zgray8298/gillis-v2/docs/design-v15.docx

Gillis V2.0 — Wiring & Pinout Reference

Rev4.1 · April 2026

# 1. System overview

Gillis is a moving-table CNC laser welder for battery-pack tab welding. The gantry is fixed; the table under it carries the cells and moves in X (left/right to the operator) and Y (toward/away from the operator). Three CL57Y closed-loop stepper drivers run the two Y motors (dual) and one X motor. A pneumatic Z head carries the presser foot and drops onto each cell before firing.

Control is split between a Teensy 4.1 (real-time motion, safety, I/O) and a Raspberry Pi 4 (user interface, program library, run orchestrator). They talk over USB CDC at 115200 baud, data-only — no power crosses the USB link.

## 1.1 Hardware list

- Teensy 4.1 (ARM Cortex-M7 @ 600 MHz, 3.3 V I/O, VBUS pad CUT — irreversible, performed during production wiring. Pendant cable carries no VBUS conductor (only D+/D- and a shared 0 V), so neither side can back-feed the other regardless of supply state. USB still enumerates because the Teensy’s USB peripheral does not require VBUS-detect to bring up the D+ pull-up: the chip is powered from VIN on the DDR-30G-5, the firmware initialises the USB stack, the Pi sees the pull-up and enumerates the device)
- Raspberry Pi 4 Model B, Official 7" DSI touchscreen
- 3 × CL57Y closed-loop stepper drivers (X, Y-left, Y-right)
- 1 × 8-channel LOW→HIGH opto isolator board — Amazon ASIN B08LVXX6MV (NPN/PNP input, NPN output)
- 1 × 8-channel HIGH→LOW opto isolator board — Amazon ASIN B08LVXK6L2 (NPN/PNP input, NPN output)
- 1 × 4-channel relay board (5 V, 3.3 V-compatible trigger, built-in per-channel opto)
- 5 × RS PRO PNP inductive/optical sensors (X home, Y-left home, Y-right home, Z up, Z down) — 24 V, sourcing output
- 1 × 0–150 psi stainless-steel pressure transducer (ratiometric 0.5–4.5 V on 5 V supply)
- 24 V main PSU feeding both the electronics box and the pendant; each has its own local 5 V buck

# 2. Power architecture

The 24 V main rail is generated centrally and splits into two mechanical enclosures: the electronics box (next to the gantry) and the operator pendant. Each enclosure has its own local 24 V → 5 V conversion — they do not share a 5 V rail.

### Electronics box

- 24 V → 5 V DC-DC (≥ 3 A) powers the relay board, the 5 V logic side of both opto boards, the air-pressure sensor and the Teensy (via VIN).
- ★ The Teensy VBUS solder pad is CUT in this build (irreversible). Cut was performed during production wiring. The Teensy is now powered exclusively from the DDR-30G-5 5 V rail via VIN and USB is a pure data link. The pendant cable carries no VBUS conductor (only D+/D- and a shared 0 V), so there is no path for the Pi to back-feed Teensy VIN — the failure mode anticipated in Rev4.14 (PSU off + USB plugged in → Pi USB overcurrent latch) is structurally impossible with this cable allocation. USB enumeration still succeeds despite VBUS-detect being unconnected on the chip side: the Teensy’s USB peripheral brings up the D+ pull-up as soon as VIN is on and the firmware initialises the USB stack, and the Pi enumerates on seeing the pull-up. Rev4.14’s premise that a VBUS conductor was required in the cable for enumeration to work was incorrect — it isn’t needed.
- Stepper motor rails are wired directly to the drivers (CL57Y handles its own motor-side supply) and do not touch Teensy logic.

### Pendant

- Local 24 V → 5 V buck (≥ 3 A) powers the Pi 4 and the 7" touchscreen ONLY.
- The Pi’s USB is connected to the Teensy for control messaging via the pendant cable. The cable carries only D+, D-, and a shared 0 V (which doubles as the 24 V return) — there is no VBUS conductor. With the Teensy’s VBUS pad cut and no VBUS on the cable, the chip’s VBUS-detect line is permanently unconnected; however the USB peripheral does not require VBUS-detect to enumerate. The Teensy enables its D+ pull-up as soon as VIN power is applied and the firmware initialises the USB stack, and the Pi enumerates on seeing the pull-up. With no VBUS path between Pi and Teensy in either direction, no back-feed of VIN can occur regardless of supply state. See the pendant cable allocation table for the full breakdown.

### Firmware flashing procedure (with VBUS pad cut)

With the VBUS pad cut, the Teensy can no longer be powered by USB alone — external 5 V on VIN is mandatory. To reflash from a development PC, swap the USB connection at the Teensy from the pendant cable to the laptop, but leave VIN connected throughout so the Teensy keeps running. The pendant USB and the laptop USB MUST NOT be plugged into the Teensy at the same time — that puts two USB hosts on one device and risks confused enumeration.

- Confirm the DIN-rail 5 V PSU is on. Teensy must have VIN power throughout the procedure — flashing will fail if VIN drops because the chip itself loses power.
- Disconnect the pendant USB cable from the Teensy USB connector. Pi can stay running — it will see the device disappear, no harm done. The 24 V, E-stop, and pendant power circuits remain connected throughout; only the USB lead is moved.
- Plug a regular USB cable from the development PC into the Teensy USB connector. Because VIN is already powering the Teensy, plugging USB does NOT cause a reboot — the chip is already up and just sees a new host appear on the data lines. Teensyduino can now issue a software reboot-to-bootloader and flash the new firmware exactly as it does in any USB-powered scenario.
- After upload completes, unplug the PC USB cable from the Teensy. Reconnect the pendant USB cable. The Pi’s serial-port watcher will re-enumerate the Teensy and the GUI will reconnect automatically.

Mounting tip: to avoid opening the electronics enclosure for every reflash, position the Teensy so its USB connector sits flush with a slot in the enclosure side, OR fit a USB-A bulkhead pass-through wired to a short USB pigtail that normally plugs into the Teensy. To reflash, unplug pendant from the bulkhead and plug the laptop in instead. Same swap, done at the box edge instead of inside.

Alternative — flash from the Pi: install teensy_loader_cli (or the Arduino IDE / arduino-cli) on the Pi and flash directly over the existing pendant USB link. Eliminates the cable swap entirely but requires the toolchain to be available on the Pi. Recommended once the firmware stabilises; cable-swap is fine for active development.

### Grounding

- All 24 V GNDs tie together at the PSU; all 5 V GNDs tie to the 24 V GND at the electronics-box DC-DC output (star point).
- Signal GND between Teensy and Pi is established by the USB shield/GND lead. Do not break it.

### Earthing (PE)

Plastic enclosure — no metal frame to bond. Two PE wires from the C14 inlet’s PE pin run in parallel, one to each mains-fed PSU’s safety earth input:

- C14 PE pin → SDR-480-48 PE input
- C14 PE pin → XDR-240E-24 FG (Frame Ground) input

No PE busbar required — the C14’s PE crimp accepts both wires in parallel. PE conductor gauge matches the L/N supply (typically 1.5 mm²), green/yellow striped per IEC 60204-1.

Not bonded to PE: CL57Y driver chassis (downstream of earthed SDR-480, no mains potential exposure on fault); DC 0 V star point (kept floating relative to PE for noise immunity); cable shields (terminate to DC 0 V at the enclosure end, not PE).

# 3. System wiring diagram

The diagram below shows the complete power and signal topology: the 24 V main supply, both 24 V → 5 V conversions, the Teensy 4.1 pin usage, both opto isolator boards with their channel assignments, the three CL57Y drivers (with ALM return paths), the 4-channel relay board, the air-pressure sensor divider, and the pendant branch.

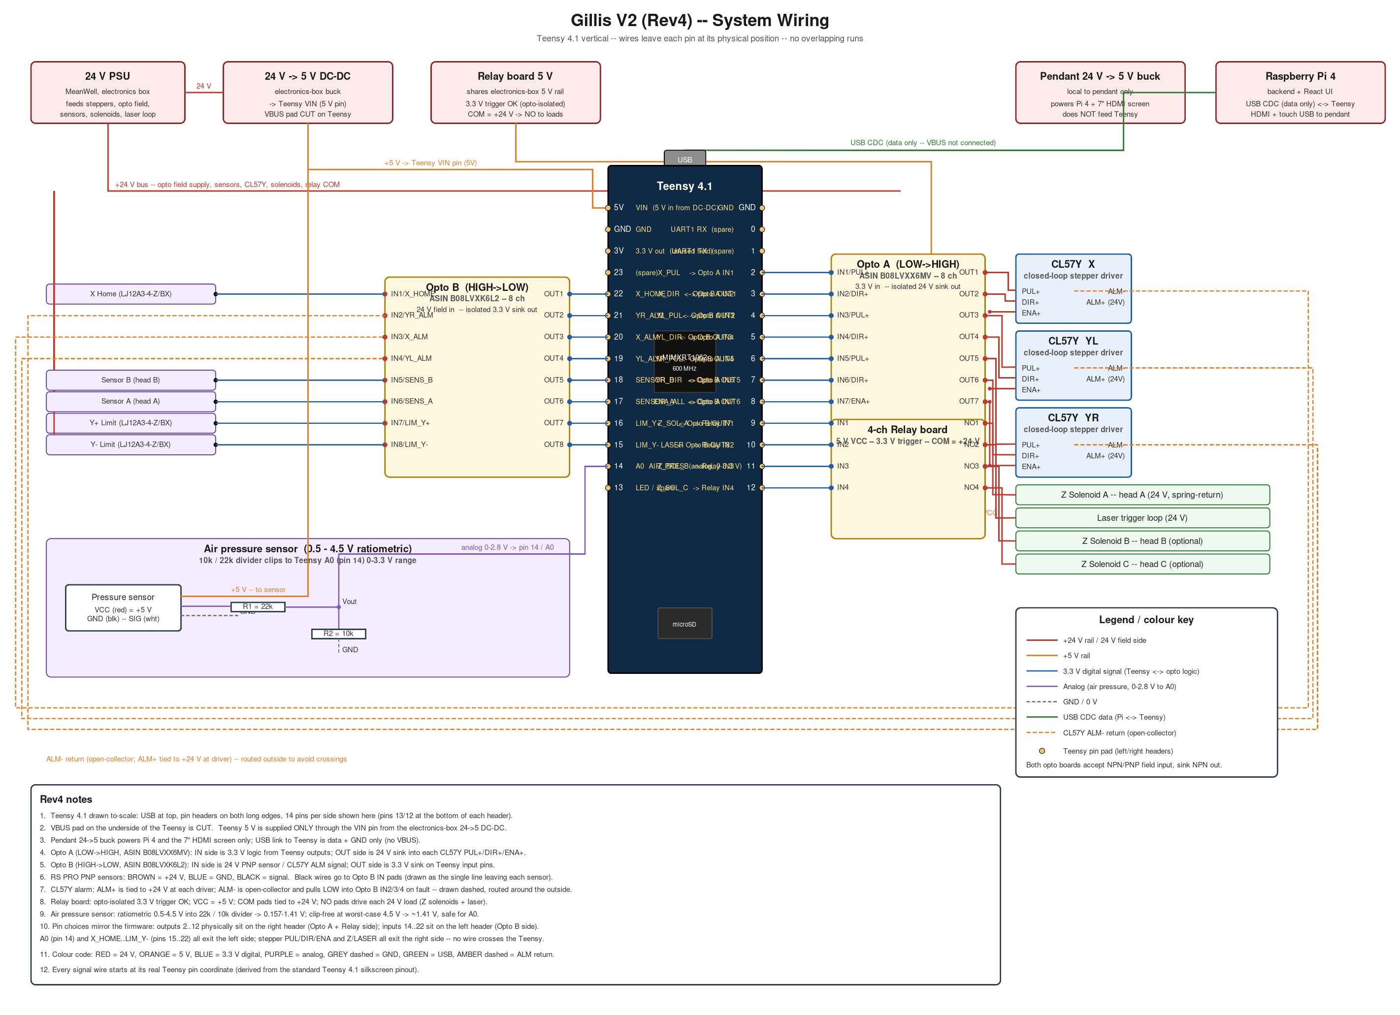
[picture p1: figure]
System wiring: 24 V PSU, electronics-box 24 V→5 V DC-DC, Teensy 4.1, LOW→HIGH and HIGH→LOW opto boards, 3× CL57Y drivers, relay board, sensors, air-pressure sensor, and pendant branch.

Figure 1 — Gillis V2 (Rev4) system wiring

### 3.1 Opto-board conventions

- Opto Board A (LOW → HIGH, B08LVXX6MV) translates Teensy 3.3 V outputs to isolated 5 V drives for the CL57Y step/dir/enable inputs. The board has a SINGLE VCC pin on the OUTPUT-side terminal block (top row); set this to 5 V from the electronics-box DDR-30G-5 (not the 24 V XDR rail). Output-side GND ties to system 0 V at the star point. Input-side (bottom row) accepts 3.3 V Teensy GPIO on the IN pins; input COM ties to Teensy GND. Input-voltage range is fixed by the on-board RP resistor pack — this unit has RP marking A471J (470 Ω, designed for ~5 V drive, gives ~4.5 mA LED current at 3.3 V). No DIP switches or solder jumpers — the RP is non-configurable in the field. Why 5 V (not 24 V) for VCC: the board’s 10 kΩ output-side pull-up array (visible as the SOIC-package “103” marking) would dissipate up to ~460 mW total at 24 V with all 8 channels active, pushing the pack near its thermal rating. At 5 V the same pull-ups dissipate <25 mW total — huge margin. The CL57Y inputs accept 5–24 V natively (manual Ch 4.3.1) so 5 V is comfortably in range.
- Opto Board B (HIGH → LOW, B08LVXK6L2) takes 24 V sensor outputs and CL57Y ALM open-collector signals and presents them to the Teensy as active-LOW inputs. The board has a SINGLE VCC pin on the OUTPUT-side terminal block (top row); set this to 3.3 V from the Teensy. Output-side GND ties to Teensy GND. Input-side (bottom row) accepts 24 V on the IN pins; input COM ties to 24 V GND for PNP-sourcing sensors and CL57Y ALM– returns. Input-voltage range is fixed by the on-board RP resistor pack — this unit has RP marking A472J (4.7 kΩ, designed for 24 V drive, gives ~4.85 mA LED current). No DIP switches or solder jumpers. Why 3.3 V (not 5 V) for VCC: the board has onboard pull-ups on each OUT pin that hold the line at VCC when the channel is idle. With VCC = 5 V, idle OUT pins would put 5 V onto Teensy 3.3 V GPIOs — out of spec, risk of GPIO damage over time. VCC = 3.3 V keeps idle pins at 3.3 V, safe for Teensy.

Both boards are "NPN/PNP input → NPN output" — they can accept either polarity on the field side (we use PNP-sourcing for sensors and the driver ALMs in pull-down-on-fault mode) and their outputs pull to GND when the input is active. That matches the firmware's INPUT_PULLUP configuration: no external pull-ups are needed.

### 3.2 CL57Y ALM wiring

The CL57Y ALM output is an optocoupler transistor between ALM+ and ALM–. With no fault it is open; on fault the transistor conducts. Wire ALM+ to +24 V and ALM– to the field-side input of Opto Board B (IN6 / IN7 / IN8). When the driver faults, the transistor pulls the opto input LOW, the opto output on the 3.3 V side turns ON (pulls to GND), and the Teensy sees the pin go LOW — consistent with every other active-LOW sensor in the firmware.

### 3.3 Air-pressure sensor

The 0–150 psi transducer runs on 5 V and outputs ratiometrically from 0.5 V (0 psi) to 4.5 V (150 psi). That peaks above the Teensy's 3.3 V analogue range, so a simple 10 kΩ / 22 kΩ divider scales it: ratio 22/(10+22) = 0.6875, giving 0.34 V at 0 psi and 3.09 V at 150 psi — comfortably inside the ADC range. Firmware uses analogReadResolution(12).

Wiring: RED → +5 V (electronics-box DC-DC), BLACK → GND, GREEN → top of divider → Teensy A0 (pin 14) tap.

# 4. Teensy 4.1 pin assignments

All digital outputs are 3.3 V and should be routed to the field side of the appropriate isolation board — Teensy GPIO does not drive 24 V loads directly. The one exception is the 4-channel relay board, which accepts a 3.3 V trigger and has its own per-channel opto built in.

### 4.1 Stepper control (outputs via Opto Board A)

Pin | Name | Direction / Level | Notes
2 | PIN_X_STEP | OUT, 3.3 V pulse | Step for X axis; min 1 µs pulse width, active HIGH. Via Opto A → CL57Y X PUL- (common-positive wiring; PUL+ ganged to +5 V).
3 | PIN_X_DIR | OUT, 3.3 V level | Direction for X; HIGH = +X. Via Opto A → CL57Y X DIR- (DIR+ ganged to +5 V).
4 | PIN_YL_STEP | OUT, 3.3 V pulse | Step for Y-left. Via Opto A → CL57Y YL PUL- (PUL+ ganged to +5 V).
5 | PIN_YL_DIR | OUT, 3.3 V level | Direction for Y-left. Via Opto A → CL57Y YL DIR- (DIR+ ganged to +5 V).
6 | PIN_YR_STEP | OUT, 3.3 V pulse | Step for Y-right. Via Opto A → CL57Y YR PUL- (PUL+ ganged to +5 V).
7 | PIN_YR_DIR | OUT, 3.3 V level | Direction for Y-right. Via Opto A → CL57Y YR DIR- (DIR+ ganged to +5 V).
8 | PIN_ALL_ENABLE | OUT, 3.3 V level | Single opto channel to all three ENA- pins (ganged). ENA+ on each driver ties to +5 V. LOW = enabled. Boots HIGH (disabled) until the Pi issues ENABLE.

### 4.2 Relay board outputs (direct 3.3 V trigger)

Pin | Name | Direction / Level | Notes
9 | PIN_Z_SOLENOID_A | OUT, 3.3 V level | Relay ch1 — Head A Z solenoid (energise = DOWN, spring-return UP). Active LOW at Teensy (relay board energises on IN LOW).
10 | PIN_LASER_RELAY | OUT, 3.3 V level | Relay ch2 — Laser trigger loop. Active LOW at Teensy for FIRE dwell only (relay board energises on IN LOW).
11 | PIN_Z_SOLENOID_B | OUT, 3.3 V level | Relay ch3 — Head B Z solenoid (Rev4; firmware ready, wiring optional until Head B fitted). Active LOW at Teensy.
12 | PIN_Z_SOLENOID_C | OUT, 3.3 V level | Relay ch4 — Head C Z solenoid (Rev4; firmware ready, wiring optional). Active LOW at Teensy.

### 4.3 Sensor inputs (via Opto Board B; active LOW at Teensy)

Pin | Name | Direction / Level | Notes
22 | PIN_X_HOME | IN, INPUT_PULLUP | X home/limit. Moved 14→22 in Rev4 bench testing to free A0; update harness.
15 | PIN_Y_LEFT_HOME | IN, INPUT_PULLUP | Y-left home/limit.
16 | PIN_Y_RIGHT_HOME | IN, INPUT_PULLUP | Y-right home/limit.
17 | PIN_Z_UP_SENSOR | IN, INPUT_PULLUP | Z head fully retracted (UP).
18 | PIN_Z_DOWN_SENSOR | IN, INPUT_PULLUP | Z head seated DOWN on cell.

### 4.4 CL57Y fault inputs (via Opto Board B; active LOW at Teensy)

Pin | Name | Direction / Level | Notes
19 | PIN_X_DRIVER_ALM | IN, INPUT_PULLUP | X driver ALM. Wire: ALM+ → +24 V, ALM– → Opto B IN6.
20 | PIN_Y_LEFT_ALM | IN, INPUT_PULLUP | Y-left driver ALM. ALM– → Opto B IN7.
21 | PIN_Y_RIGHT_ALM | IN, INPUT_PULLUP | Y-right driver ALM. ALM– → Opto B IN8.

### 4.5 Analogue input

Pin | Name | Direction / Level | Notes
14 (A0) | PIN_AIR_PRESSURE | ANALOGUE, 12-bit | Air-pressure sensor via 10 k / 22 k divider. Scaling lives in config.h.

# 5. Opto board channel maps

## 5.1 Opto Board A — LOW → HIGH (B08LVXX6MV)

Teensy 3.3 V outputs drive the input-side opto LEDs; each output-side NPN transistor pulls the corresponding CL57Y signal to 0 V (output-side GND) when the Teensy pin is HIGH. Use the board’s COM (output-side) as the CL57Y signal return. Output-side VCC = 5 V from the DDR-30G-5 (see §3.1 for why 5 V not 24 V, and for the RP-fixed input voltage).

Ch | Logic-side source | Field-side destination | Notes
IN1 | Teensy Pin 2 (X_STEP) | CL57Y X PUL- | 5 V opto drive to driver step input
IN2 | Teensy Pin 3 (X_DIR) | CL57Y X DIR- | Driver direction input
IN3 | Teensy Pin 4 (YL_STEP) | CL57Y YL PUL-
IN4 | Teensy Pin 5 (YL_DIR) | CL57Y YL DIR-
IN5 | Teensy Pin 6 (YR_STEP) | CL57Y YR PUL-
IN6 | Teensy Pin 7 (YR_DIR) | CL57Y YR DIR-
IN7 | Teensy Pin 8 (ALL_ENA) | All 3 CL57Y ENA- | Single channel ganged to all drivers
IN8 | — spare — | — | Unused; leave disconnected

## 5.2 Opto Board B — HIGH → LOW (B08LVXK6L2)

Each 24 V field input drives the optocoupler LED; the logic-side NPN transistor pulls the Teensy input to GND when active. Teensy pins are set INPUT_PULLUP, so no external pull-up resistors are required.

Ch | Logic-side source | Field-side destination | Notes
IN1 | X_HOME sensor (BLK) | Teensy Pin 22 | RS PRO PNP 24 V sensor → active LOW at Teensy
IN2 | YL_HOME sensor (BLK) | Teensy Pin 15
IN3 | YR_HOME sensor (BLK) | Teensy Pin 16
IN4 | Z_UP sensor (BLK) | Teensy Pin 17
IN5 | Z_DOWN sensor (BLK) | Teensy Pin 18
IN6 | X driver ALM– | Teensy Pin 19 | ALM+ → +24 V; open-collector pulls ALM– to GND on fault
IN7 | YL driver ALM– | Teensy Pin 20
IN8 | YR driver ALM– | Teensy Pin 21

★ Using 3 of the 8 fault inputs for CL57Y ALM takes the HIGH→LOW board to full capacity (5 sensors + 3 ALM = 8). If you add Head B / Head C Z sensors in future, a second HIGH→LOW opto board will be required.

# 6. Connector reference

### 6.1 RS PRO PNP sensor wiring

- BROWN → +24 V
- BLUE → 24 V GND
- WHITE → Opto Board B input (PNP NC output — sources +24 V when sensor IS triggered with the sensor variant in use, after BLACK was found to give inverted polarity at the Teensy on 2026-05-03; see Rev4.7 entry)

### 6.2 CL57Y driver wiring

- PUL+ / DIR+ / ENA+ — ganged together to +5 V from electronics-box DDR-30G-5 (common-positive wiring per CL57Y manual page 9). All three + pins per driver share a single +5 V tap; can also be ganged across all 3 drivers to a single +5 V wire if convenient.
- PUL- / DIR- / ENA- ← Opto Board A channel OUT pin (each - pin to its respective channel: PUL- → step channel OUT, DIR- → dir channel OUT, ENA- → Ch7 OUT, ganged across all 3 drivers since ENA is shared). When the channel activates (Teensy IN HIGH), the opto NPN closes and pulls the - pin to GND, completing the LED loop from +5 V → CL57Y internal LED + 1.5 kΩ current limiter → - pin → opto NPN → GND. Result: ~2.5 mA LED activation, well above the EL814’s reliable threshold.
- ALM+ → +24 V (tied at driver)
- ALM– → Opto Board B input (channel per driver)

Motor + encoder wiring (StepperOnline 23HS40-5004D-E1K-1M5):

The motor ships with two cables. The thicker 4-conductor (TRVV4×0.5mm²) is the motor power cable; the thinner 6-conductor shielded (TRVVP6×0.2mm²) is the encoder cable. Wire colours overlap between the two cables — identify by conductor count (4 vs 6) before stripping.

Motor power cable (4-conductor, 0.5 mm²):

Motor wire | Phase | CL57Y terminal
BLK (Black) | A+ | A+
GRN (Green) | A- | A-
RED (Red) | B+ | B+
BLU (Blue) | B- | B-

Encoder cable (6-conductor shielded, 0.2 mm²) — 1000 PPR / 4000 CPR after quadrature decode:

Encoder wire | Function | CL57Y terminal
BLK (Black) | Encoder A+ | EA+
BLU (Blue) | Encoder A- | EA-
YEL (Yellow) | Encoder B+ | EB+
GRN (Green) | Encoder B- | EB-
RED (Red) | +5 V to encoder | VCC
WHT (White) | Encoder GND | EGND

Cable shield drain: terminate to CL57Y chassis at one end only (driver end). Don’t land on EGND — that injects shield-drain current into the encoder ground reference. Common failure modes if mis-wired: A↔A- swap causes immediate 5-flash position-overrun alarm on first commanded move; VCC↔EGND swap kills the encoder silently; A pair swapped with B pair causes erratic motion at low speeds (90° phase shift in feedback).

### 6.3 Relay board wiring (4-channel, 5 V)

- VCC → electronics-box 5 V, GND → common
- If the board has a JD-VCC / VCC jumper, leave it fitted (Teensy-powered trigger side)
- IN1 ← Pin 9 (Z_SOL_A), IN2 ← Pin 10 (LASER), IN3 ← Pin 11 (Z_SOL_B), IN4 ← Pin 12 (Z_SOL_C)
- Each relay: COM = +24 V, NO = solenoid / laser trigger loop, GND = 24 V GND
- Each pneumatic solenoid coil MUST have flyback diode protection — either built into the DIN 43650 connector OR added externally as a 1N4007. Without it, back-EMF spikes (100–500 V transients during de-energise) radiate enough EMI to trigger spurious driver fault signals at the Teensy even with ALM signal wires physically disconnected. See §6.3.1 below for installation instructions.

### 6.3.1 Flyback diode installation (per solenoid)

Step 1 — Test if the existing connector has a diode. Unplug the DIN 43650 connector from the valve. Set multimeter to diode-test mode. Probe across L+ and N– in BOTH directions: forward direction shows ~1.7–2.0 V (LED forward voltage); reverse direction shows ~0.7 V if a flyback diode is present, OL (open) if only an LED is fitted. If reverse reads OL on any solenoid, that solenoid needs an external diode added.

Step 2 — Add 1N4007 across each unprotected coil. 1N4007 (or any 1N400x with x ≥ 4): 1 A, 1000 V. CRITICAL ORIENTATION: cathode end (silver/grey band) goes to the COIL + side (the wire that comes from the relay NO terminal); anode (plain end) goes to the COIL – side (the GND return). Wired backwards, the diode shorts the coil and prevents it from energising at all.

Installation location options (best to worst):

- Inside the DIN 43650 connector body (open the connector, install across the L+ and N– screw terminals, close back up) — closest to the source, best EMI suppression.
- Replace the LED-only connector with an LED-and-diode variant (Heschen and similar sell “with surge suppressor” versions ~£3–5 each).
- At the relay-board terminal block end (slide the diode leads into the same screw terminals as the existing wires from relay NO and GND). Electrically equivalent to the connector-end install but slightly worse for EMI radiation along the wire run.

After installing diodes on all 3 solenoids, verify by triggering each one from the GUI: relay clicks, valve actuates, no driver-fault dialogs appear in the GUI. If false faults persist with all 3 diodes installed, suspect a 24 V supply rail dip (add a 100 μF bulk capacitor at the relay board’s +24 V input) or shared-ground noise (re-route solenoid wiring away from Teensy/Opto B signal cables, twist + and – conductors together).

### 6.4 Air-pressure sensor wiring

- RED = +5 V (electronics-box DC-DC)
- BLACK = GND
- GREEN = signal through 10 kΩ (top) / 22 kΩ (bottom) divider to Teensy A0 (pin 14)

### 6.5 CL57Y dip switch settings

Set on each of the three drivers. Power-cycle the driver (drop and re-apply 24 V on V+) after any dip-switch change — settings are read at boot only.

SW | Function | Setting | Reason
SW1 | Pulse mode | OFF | PU&DR mode (single pulse + direction signal). Matches firmware which drives PIN_X_STEP and PIN_X_DIR as separate signals.
SW2 | Direction | OFF* | *Verify per axis at commissioning. OFF = CW when DIR active. For dual-Y (YL+YR), the two motors face each other so they typically need OPPOSITE SW2 settings to drive the gantry the same linear direction.
SW3 | Servo mode | OFF | Servo mode 1 — smoother low-speed response, suited to heavy gantry with slow precise moves. Servo mode 2 (ON) is for light loads with fast positioning.
SW4 | ALM polarity | OFF | ALM signal normally OPEN (transistor closes on fault). Matches existing ALM wiring in §3.2 (ALM+ to +24 V, ALM- pulled to GND on fault).
SW5 | Microstep bit 0 | OFF | Combined with SW6/SW7/SW8 to set 3200 pulses/rev (16 microsteps × 200 full steps). Matches firmware MICROSTEPS=16 in config.h.
SW6 | Microstep bit 1 | OFF | Same as above — 3200 pulses/rev.
SW7 | Microstep bit 2 | ON | Same as above — 3200 pulses/rev.
SW8 | Microstep bit 3 | ON | Same as above — 3200 pulses/rev. Result: 640 steps/mm with 5 mm-pitch ballscrews; 128 kHz pulse rate at 200 mm/s (36% headroom under CL57Y’s 200 kHz max).

If you ever change MICROSTEPS in firmware: SW5–SW8 must match. CL57Y manual Ch 4.2.2 has the full pulses/rev table. For example, doubling to 32 microsteps (6400 pulses/rev) would need SW5/SW6/SW7=ON, SW8=OFF and a config.h update — but check the max pulse rate (640 × 2 = 1280 steps/mm; at 200 mm/s = 256 kHz, exceeds CL57Y’s 200 kHz limit). 16× is the practical maximum for this mechanical setup.

# 7. Firmware-visible behaviour

- All sensor inputs and ALM inputs are active LOW at the Teensy pin. This is consistent across every input on both opto boards, which keeps the firmware's INPUT_PULLUP + digitalRead checks uniform.
- ALL_ENABLE is active LOW at the CL57Y driver. Firmware boots with Teensy Pin 8 HIGH, which keeps the opto off → CL57Y ENA+ / ENA– open → drivers DISABLED. The Pi issues ENABLE once the UI is ready.
- FIRE pulses the laser relay LOW for dwell_ms configured in settings.h (the 4-ch 24 V relay board is active-LOW at its 3.3 V trigger inputs); the relay board's built-in opto handles isolation.
- Z solenoid energise lowers the Z head; spring-return lifts it when relay drops.
- The Pi-side heartbeat PINGs every 500 ms; firmware trips FAULT_LINK_LOST after 2000 ms silence (watchdog, see master plan §8).

# 8. E-stop architecture and always-on rail

The E-stop kills two power paths simultaneously through a pair of DPDT relays driven from a single NC button loop. Hardware power is restored automatically on E-stop release; the firmware provides the latch via a GUI-acknowledged FAULT state (see §8.4).

## 8.1 Hardware topology

- Relay R1 (Mxuteuk PTF08A-E, DPDT, 24 VDC coil) — both poles used to switch AC L AND AC N to the 48 V SDR-480-48 PSU. Double-pole isolation per IEC 60204-1; single-pole break is not used. NO contacts on both poles, so coil-energised = AC delivered.
- Relay R2 (Mxuteuk PTF08A-E, DPDT, 24 VDC coil) — one pole used to switch +24 V (high-side) to the 4-channel relay board which drives the Heschen 4V210-08 pneumatic solenoid coils. Pole 2 left as a spare. NO contact, so coil-energised = +24 V delivered to solenoids.
- E-stop button — normally-closed (NC) contacts, positive opening per IEC 60947-5-5. Wired in series with both relay coils, so press → loop opens → both coils drop together. Broken wire produces same shutdown (fail-safe direction).
- No hardware latch — releasing the E-stop re-energises both coils and restores AC + 24 V immediately. The firmware fault-state (§8.4) acts as the operator-acknowledged latch.
- Coil supply — both R1 and R2 coils take +24 V from the always-on rail (XDR-240E output, upstream of R2’s contacts). The coils’ 0 V return goes directly to the XDR 0 V. Coil current ~30 mA each, well within the E-stop contact rating.

## 8.2 Mxuteuk PTF08A-E pin reference

PTF08A-E sockets carry 8 numbered terminals (1–8) for an 8-pin DPDT relay (MY2N-J style). Pin functions and physical positions below are verified against the printed diagram on the actual relay body and the annotated socket photo (Figure 2).

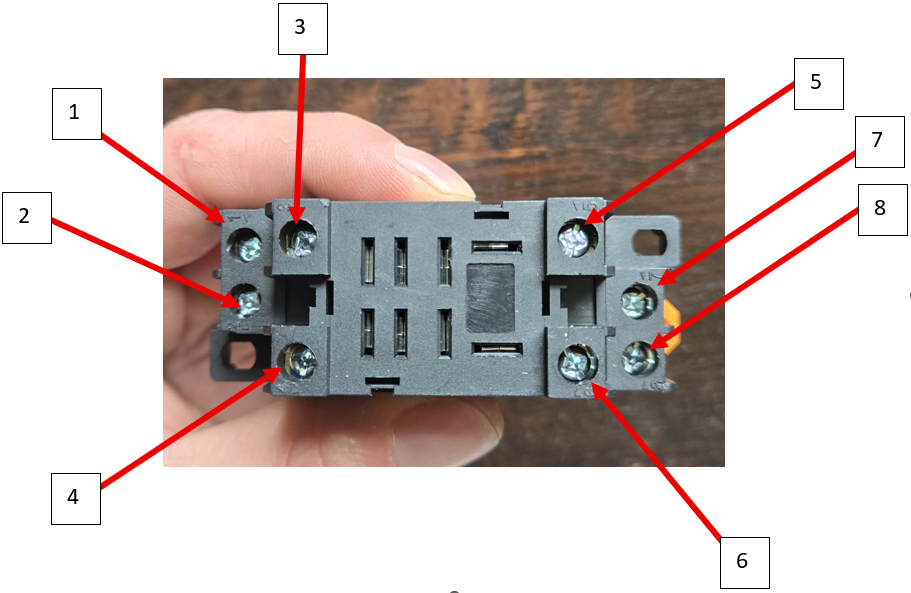
[picture p2: figure]
Annotated Mxuteuk socket photo

Figure 2 — Mxuteuk PTF08A-E DIN-rail socket, annotated with physical pin positions.

Pin | Position | Function | R1 connection (AC switching) | R2 connection (24 V switching)
1 | Top-outer-left | NC pole 1 | unused (spare) | unused (spare)
2 | Mid-outer-left | NC pole 2 | unused (spare) | unused (spare)
3 | Top-inner-left | COM pole 1 | AC L from C14 inlet (after main switch) | +24 V from XDR always-on rail
4 | Bottom-outer-left | COM pole 2 | AC N from C14 inlet | unused (pole 2 spare)
5 | Top-inner-right | NO pole 1 | AC L → SDR-480-48 input L | switched +24 V → 4-ch relay board +24 V
6 | Bottom-inner-right | NO pole 2 | AC N → SDR-480-48 input N | unused (pole 2 spare)
7 | Top-outer-right | Coil A2 (−) | 0 V system GND | 0 V system GND
8 | Mid-outer-right | Coil A1 (+) | +24 V via E-stop NC contact | +24 V via E-stop NC contact (parallel with R1 pin 8)

Contact rating: 10 A @ 250 VAC / 5 A @ 30 VDC, well above the SDR-480-48’s ~3 A AC draw and the solenoid bank’s ~0.75 A peak DC. Coil: 24 VDC variant required.

## 8.3 Always-on rail — NOT cut by E-stop

The XDR-240E-24 is wired directly to the C14 mains inlet (upstream of R1) so its 24 V output is available regardless of E-stop state. The following loads draw from this always-on rail and remain powered when E-stop is pressed:

- Electronics-box 24→5 V DC-DC — feeds Teensy VIN, opto-board logic side, the 4-ch relay board logic, and the air-pressure transducer. Keeps the firmware running so it can detect driver alarms (§3.2) and transition to FAULT.
- Pendant 24→5 V buck (Pi 4 + 7” touchscreen) — GUI stays responsive during E-stop so the operator can see and dismiss the FAULT.
- R1 + R2 coil supply — control loop runs from the always-on rail through the E-stop NC contacts. The coil supply itself is never gated; only the loop’s closure state changes.

Loads that ARE cut by E-stop: AC mains to the SDR-480-48 (so +48 V to the three CL57Y drivers disappears), and +24 V to the 4-channel relay board (so all pneumatic valves spring back to safe state).

## 8.4 Fault-state behaviour (firmware latch via GUI)

Hardware auto-restores power on E-stop release, but the machine cannot operate until the operator dismisses the fault on the Pi GUI. The chain is:

- E-stop pressed → R1 drops → +48 V cut to all three CL57Y drivers.
- Drivers detect loss-of-power and assert their ALM open-collector outputs (ALM– pulled to GND).
- Opto Board B IN6/IN7/IN8 see the 24 V drop → logic-side outputs pull Teensy pins 19/20/21 LOW.
- Firmware reads the active-LOW alarm pins and transitions the state machine to FAULT.
- Pi GUI displays the fault and blocks all motion commands.
- E-stop released → R1 + R2 re-energise → 48 V and 24 V return — but firmware stays in FAULT.
- Operator clicks “Acknowledge fault” on the GUI → firmware toggles ALL_ENABLE (Pin 8 HIGH→LOW transition) to clear the driver-side alarm latch → state machine returns to IDLE.

CL57Y alarm reset (verified against StepperOnline CL57Y manual V1.0, Chapter 5):

Fault (red ALM flash count) | Flashes | Reset method
Overcurrent / interphase short | 1× | Power-off reset only (full V+ cycle).
Overvoltage of supply | 2× | Auto-recovers when V+ returns to spec range.
Undervoltage of supply | 3× | Auto-recovers when V+ returns to spec range.
Drive overtolerance (position over-error) | 5× | MF/ENA toggle (drive Pin 8 HIGH briefly) clears alarm. Power-off also works.

For Gillis V2 the E-stop case is the easy one: pressing E-stop fully cuts V+ at the SDR-480-48 output, so each CL57Y is hard power-cycled. On release, the drivers reboot fresh with no latched alarm state — no firmware ENA toggle is required to clear an E-stop-induced fault. The firmware just needs to wait for the ALM pins to indicate no fault before re-issuing ENABLE (Pin 8 LOW) and returning to IDLE.

The firmware ENA toggle IS still needed for the 5-flash “position over-tolerance” fault that occurs during normal operation when V+ never dropped — this latches and the manual states it’s cleared by setting MF (the enable input) to its “invalid” / disabled state. That maps to driving Teensy Pin 8 HIGH (which the firmware already does at boot), then back LOW to re-enable.

Related dip-switch settings (verify on each driver): SW4 = OFF (“ALM signal normally open”) — this matches the existing wiring (ALM+ to +24 V, ALM– pulled LOW on fault). SW1, SW2, SW3 set per axis; SW5–SW8 set the microstep subdivision per the manual’s table (16 settings from 400 to 51200 pulses/rev).

# 9. DC fusing

Five DC fuses on the bench, plus the C14 inlet’s integral mains fuses (not in this list — they protect the AC side and are sized to the upstream breaker).

# | Rating | Size / format | Location | Reason

1 | T5 A slow-blow | 5×20 mm ceramic | X driver V+ (between 48 V busbar and CL57Y X V+ pin) | Per-driver isolation; rides through V+ cap inrush at boot.
2 | T5 A slow-blow | 5×20 mm ceramic | YL driver V+ (between 48 V busbar and CL57Y YL V+ pin) | Per-driver isolation.
3 | T5 A slow-blow | 5×20 mm ceramic | YR driver V+ (between 48 V busbar and CL57Y YR V+ pin) | Per-driver isolation.
4 | T1 A slow-blow | 5×20 mm glass | DDR-30G-5 5 V output → Teensy and downstream 5 V loads (opto board logic, 4-ch relay logic side, air sensor, CL57Y +pin gangs) | Catches downstream shorts faster than DDR-30G-5’s ~6 A onboard current limit. Typical 5 V load is ~300–500 mA, 1 A leaves margin without nuisance-tripping on Teensy boot.
5 | T2 A slow-blow | 5×20 mm glass | 24 V XDR output → pendant cable (Pi 4 + 7” touchscreen via pendant buck) | Continuous ~250–400 mA; ~1 A inrush during Pi boot. T2 A handles inrush without nuisance-tripping.

## 9.1 Branches deliberately NOT fused

- 4-ch relay board 24 V input — gated by R2; the 4-ch board itself fans out to 3 solenoid coils. Continuous load ~420 mA worst case; XDR’s onboard current limit handles a sustained short.
- E-stop control loop (24 V → E-stop NC → R1+R2 coils → 0 V) — coil current ~60 mA total. A blown fuse here would silently disable the E-stop, which is an unacceptable failure mode. Rely on XDR’s current limit.
- Sensor BROWN wires individually — 5 sensors share the +24 V bus; per-sensor fuses would add 5 wear items for marginal benefit. Upstream protection (XDR current limit) handles a single sensor short.
- 3.3 V from Teensy to opto board logic VCCs — Teensy onboard 3.3 V regulator current limits at ~250 mA. The regulator IS the fuse for this rail.
- DDR-30G-5 24 V input — protected by the XDR’s current limit + the DDR’s own input under-voltage / reverse-polarity protections. (If you ever want belt-and-braces, T3.15 A 5×20 mm slow-blow rides through the DDR’s 15 A inrush.)

# 10. Change log

- Rev4.15 (2026-05-13): Spec corrections from BOM review with Zack. (a) Removed §8.3 bullet for “HG30 MPG handwheel” — confirmed never built and never to be built; the pendant has no MPG. The Pi + screen power-retention behaviour during E-stop is already covered by the existing “Pendant 24→5 V buck” bullet. Also removed the stray HG30 mention from the Rev4.2 entry below. (b) Removed “SONGLE” branding from §4.2 pin notes (ch1, ch2) and §7 FIRE description — the installed 4-channel relay board is the 24 V coil variant with built-in optos, driven direct from Teensy 3.3 V GPIO. The SRD-05VDC-SL-C / SONGLE attribution in the Rev4.12 entry below is incorrect; the active-LOW behaviour documented there is correct and unchanged. (c) Partially revised Rev4.14 below: the Teensy VBUS pad IS cut as that entry states, BUT the pendant cable does NOT carry +5 V VBUS — Zack confirmed only D+/D- and a shared 0 V run through the cable. The chip’s VBUS-detect line is therefore permanently unconnected, yet USB enumeration works fine because the Teensy’s USB peripheral does not require VBUS-detect to bring up the D+ pull-up — once VIN powers the chip and the firmware initialises USB, the Pi sees the pull-up and enumerates. With no VBUS path in either direction, no back-feed of VIN can occur regardless of supply state, so the original concern that motivated Rev4.14 is structurally resolved by the cable allocation alone. Updated §1.1, §2 power architecture, and §6 pendant cable description to reflect this. Firmware-flashing subsection title and intro left as Rev4.14 wrote them — they are correct since the pad really is cut.
- Rev4.14 (2026-05-09): Reversed §1.1 / §2 VBUS guidance: pad is now CUT and the pendant cable now carries +5 V VBUS on a dedicated conductor. Trigger was the production-wiring brownout failure mode (PSU off + USB plugged in = Pi USB overcurrent latch + Teensy offline). Cutting the pad and routing VBUS through the cable makes this failure class structurally impossible: USB powers only the chip’s VBUS-detect pin, never VIN. Pendant 6-core allocation reorganised — the previous separate 24 V-to-pendant-buck wire and 24 V-to-E-stop-input wire are merged into a single 24 V supply (split at the pendant end into buck input and E-stop button input), freeing one core for VBUS. New allocation: (1) 24 V, (2) +5 V VBUS, (3) E-stop return, (4) D+, (5) D-, (6) shared 0 V/GND. Added firmware-flashing-with-pad-cut subsection documenting the cable-swap workflow now required for reflashing.
- Rev4.13 (2026-05-05): Expanded §6.3 with new §6.3.1 covering flyback diode installation. The integrated DIN 43650 connectors on Gillis V2’s Heschen 4V210-08 valves were verified to have LED indicators only (no flyback diode). Without flyback protection, solenoid back-EMF spikes radiate sufficient EMI to trigger spurious FAULT_DRIVER_X / YL / YR events at the Teensy (random pin susceptibility), even with the ALM signal wires physically disconnected from Opto Board B — the EMI couples directly into the Teensy chip. Mandatory: install a 1N4007 across each solenoid coil with cathode (band) toward the relay-NO side. Subsection details the multimeter test for diode presence, install location ranking, and post-install verification.
- Rev4.12 (2026-05-05): SAFETY-CRITICAL FIX: 4-ch SONGLE relay board (SRD-05VDC-SL-C) verified empirically as ACTIVE-LOW input, not active-HIGH as previously documented. Pulling IN to GND fires the opto and energises the relay; idle HIGH state leaves it de-energised. Firmware updated across pins.h boot init, fault_handler.h emergency_stop_outputs, z_control.h z_deenergise_all + z_down, and serial_protocol.h laser_fire to invert HIGH/LOW writes accordingly. Without this fix, the firmware’s boot init was writing all four relay outputs LOW with the comment “all OFF on boot” — in reality this energised all 3 Z solenoids and asserted the laser fire signal at every Teensy reset, before firmware took over. Hazard mitigated by R2’s gating of +24 V to the relay board until E-stop close, but still a latent boot-time fault. §4.2, §7, §2 updated to reflect active-LOW convention.
- Rev4.11 (2026-05-05): Mxuteuk PTF08A-E pin reference (§8.2) verified empirically against the printed contact diagram on the actual relay body and against an annotated socket photo (now embedded as Figure 2). Pin functions corrected from prior assumed mapping: 1=NC1, 2=NC2, 3=COM1, 4=COM2, 5=NO1, 6=NO2, 7=A2 (–), 8=A1 (+). R1 connections updated: AC L lands on pin 3, AC N on pin 4; switched outputs on pins 5 (L) and 6 (N); coil + on pin 8, coil – on pin 7. R2 same pattern, only pole 1 used. Added §2 Earthing subsection: in this plastic enclosure with no PE busbar, two parallel PE wires run from the C14 inlet’s PE pin direct to the SDR-480 PE input and the XDR-240E FG input. CL57Y chassis bonds, 0V↔PE bond, and cable-shield-to-PE all deliberately omitted with reasoning.
- Rev4.10 (2026-05-03): Section 9 driver fuses changed from 10×38 mm DIN ceramic (PV-style) to 5×20 mm ceramic, slow-blow, 250 V (T5 A). Holders identified as IEC 60947-7-1 compliant 5×20 fuse holders for the 24 V branch — same physical format works for the 48 V driver branches given the SDR-480-48’s onboard ~10 A output current limit (well within 5×20 ceramic breaking capacity at 48 V DC). All 5 fuses now standardised on 5×20 mm slow-blow ceramic, sourced from a single AUKENIEN 75-piece kit covering T0.5A through T20A.
- Rev4.9 (2026-05-03): Added Section 9 covering DC fusing — 5 fuses total (3× T5 A 10×38 DIN on per-driver V+, 1× T1 A 5×20 glass on DDR-30G-5 5 V output to Teensy, 1× T2 A 5×20 glass on 24 V to pendant cable). Plus §9.1 listing branches deliberately not fused (4-ch relay board input, E-stop loop, individual sensors, 3.3 V Teensy regulator output, DDR-30G-5 24 V input) with reasoning. Renumbered Change log from 9 to 10.
- Rev4.8 (2026-05-03): Reversed the “Teensy VBUS pad MUST be cut” advice in §1.1 and §2 (Power architecture). The pendant cable carries only D+/D- and a shared 0 V — no VBUS conductor — so no Pi-to-VIN power fight is possible in production regardless of pad state. Critically, leaving the pad INTACT supplies VBUS-detect locally from VIN, which the Teensy’s USB controller needs to enumerate; cutting the pad with no external VBUS source would prevent USB enumeration entirely. Pad cut is also irreversible. The previous “cut” advice was based on an assumed full-USB cable topology that doesn’t match Gillis V2’s actual pendant wiring.
- Rev4.7 (2026-05-03): Section 4.1 and Section 5.1 updated to show Teensy step/dir/enable signals routing to the CL57Y – pins (not + pins) per the corrected common-positive wiring in §6.2. Section 6.1 sensor wire colour changed from BLACK to WHITE – with the specific RS PRO sensor variant in use, BLACK gave inverted polarity at the Teensy (sensor idle read as triggered), causing homing to immediately think the gantry was at home and skip the seek motion. WHITE (PNP NC output) gives the correct polarity. Added FAULT_Y_GANTRY_RACK firmware fault: during homing, if the first Y home sensor triggers but the second doesn’t follow within 500 ms (configurable as HOMING_Y_DUAL_TIMEOUT_MS), motion stops immediately and the firmware faults — protects the gantry from racking if one Y motor stalls or one home sensor fails.
- Rev4.6 (2026-05-03): Section 6.2 CL57Y signal wiring corrected to common-positive (+ pins ganged to +5 V, - pins to opto OUT) — the previous “+ to OUT, - to GND” topology gave only ~0.3 mA LED current via the 10 kΩ pull-up, well below the CL57Y opto threshold, causing motor to not respond to PUL/DIR/MF signals. New wiring sources current properly through the opto NPN sink path, ~2.5 mA LED current. Section 6.2 now also documents motor power and encoder cable colour mapping for the StepperOnline 23HS40-5004D-E1K-1M5. New Section 6.5 added covering CL57Y dip switches SW1–SW8 with chosen settings and reasoning, including the 16-microstep / 3200 pulses-per-rev / 640 steps-per-mm calculation that matches firmware config.h.
- Rev4.5 (2026-04-28): Corrected Section 3.1 to match actual board hardware. These opto isolator boards have a SINGLE VCC pin on the output-side terminal block, not separate logic/field VCCs as previously written. VCC sets the output-side rail voltage; input current limiting is fixed by the on-board RP resistor pack (no DIP switches or solder jumpers). Captured actual RP values for Gillis V2’s units: Opto A = A471J (470 Ω, ~5 V variant), Opto B = A472J (4.7 kΩ, 24 V variant). Confirmed VCC choices: 5 V on Opto A (avoids 10 kΩ pull-up array overheating that would occur at 24 V), 3.3 V on Opto B (keeps idle output pins safe for Teensy GPIO). Section 5.1 intro updated to match the corrected terminology.
- Rev4.4 (2026-04-28): Corrected Opto Board A (B08LVXX6MV) field-side VCC from 24 V to 5 V across §3.1, §5.1, and §6.2. The board has onboard pull-up resistors sized for ~5 V; driving them from 24 V would dissipate excessively across 8 channels. CL57Y inputs accept 5–24 V natively (manual Ch 4.3.1), so 5 V at PUL/DIR/MF works fine. Opto Board B (B08LVXK6L2) field VCC remains 24 V — that board has 24 V-rated input current limiting.
- Rev4.3 (2026-04-28): Replaced the speculative “verify CL57Y reset behaviour” note in §8.4 with the verified alarm-reset matrix from the StepperOnline CL57Y manual V1.0 (Chapter 5). Confirmed the E-stop case is a full V+ power cycle — drivers reboot fresh with no latched alarm; firmware ENA toggle only required for 5-flash position-overrun faults. Added SW4 dip-switch note (OFF = ALM normally open, matches existing wiring).
- Rev4.2 (2026-04-28): Added Section 8 (E-stop architecture and always-on rail). Documented 2× Mxuteuk PTF08A-E DPDT relays (R1 cuts AC L+N to SDR-480-48; R2 cuts +24 V to solenoid relay board), pin numbering 1–8 with R1/R2 connections, the always-on rail (Teensy 5 V DC-DC, Pi + screen, both relay coils) which is NOT cut by E-stop, and the firmware FAULT-state behaviour with GUI acknowledgement. Renumbered Change log from 8 to 9.
- Rev4.1 (2026-04-24): Added system wiring diagram (Figure 1). Documented opto board model numbers (B08LVXX6MV / B08LVXK6L2) and CL57Y ALM routing through Opto Board B. Confirmed 5 sensors + 3 ALM = 8 input channels (full board).
- Rev4 (2026-04): Moved PIN_X_HOME from 14 → 22 to free A0 for the air-pressure sensor. Corrected Teensy power path (5 V in via electronics-box DC-DC, VBUS pad cut). Added solenoid B/C firmware pins (relay ch3/ch4).

Gillis V2 — Wiring & Pinout Reference
