zgray8298/gillis-v2/docs/Gillis_Onsite_Deploy_Runbook.docx

Gillis V2 — Onsite Deploy Runbook

For client visit — work from this when you arrive

## Quick reference

Pi user | ionetic
Pi default name | Gillis.local (mDNS — may not work on a strange WiFi)
Project on Pi | /home/ionetic/Desktop/gillis-v2-ui-v2
SSH key | gillis_deploy_key (lives next to the deploy script in the kit folder)
Deploy script | deploy-pi-onsite.ps1 (builds ON the Pi — no Node.js needed on the PC)
Backend port | 8787 (Chromium kiosk points at http://localhost:8787)

# 1. Pi onto client's WiFi

Power up the Pi and wait for the desktop to come up. If the Chromium kiosk auto-launches and fills the screen, press Alt+F4 (USB keyboard) or Ctrl+Q to drop out of it.

On the touchscreen:

1. Click the network icon in the top-right of the taskbar.
2. Pick the client's SSID and enter their password.
3. Open a terminal — right-click the desktop and pick "Open in Terminal", or press Ctrl+Alt+T.
4. Run hostname -I and note (or photograph) the IPv4 address. Likely 10.x.x.x or 192.168.x.x.

hostname -I

Terminal-only alternative if you have a keyboard but no touch:

sudo nmcli device wifi connect "CLIENT_SSID" password "THE_PASSWORD"

# 2. Connect the client PC to the same WiFi

Critical — both machines must be on the same network for SSH to work. If the client PC is wired to a separate VLAN you can't see the Pi from, the bailout is to put both on your phone's hotspot, or run an Ethernet cable straight from PC to Pi (Windows will give them link-local 169.254.x.x addresses and they can talk).

# 3. Copy the kit off the USB stick

Plug the USB stick into the client PC. The drive letter will probably be D:, E:, or F: — open PowerShell and check:

Get-Volume | Where-Object DriveType -eq Removable | Select-Object DriveLetter, FileSystemLabel

Substitute your actual drive letter below (the USB had label "Claude Programming").

Copy-Item "D:\Claude Programming" -Destination "$env:USERPROFILE\Desktop\" -Recurse

The folder is now at C:\Users\<you>\Desktop\Claude Programming\ with the SSH key (gillis_deploy_key) sitting inside it.

# 4. One-time PowerShell setup

Open PowerShell (Start menu → type "powershell" → Enter), then allow scripts to run for your user:

Set-ExecutionPolicy -Scope CurrentUser -ExecutionPolicy RemoteSigned

Type Y and hit Enter to confirm. Only needed once on that PC.

# 5. Deploy

cd "$env:USERPROFILE\Desktop\Claude Programming"

.\deploy-pi-onsite.ps1

What happens, in order:

5. It tries to reach the Pi at Gillis.local (likely fails on strange WiFi).
6. Then 192.168.11.212 (your home IP — also fails).
7. Then it prompts: "Enter the IP it printed". Type the IP from Step 1, hit Enter.
8. First SSH connection asks Are you sure you want to continue connecting (yes/no)? — type yes, Enter.
9. Pushes source to the Pi, builds on the Pi (~30–60s), prints Done.

# 6. Reload the GUI on the Pi

Backend is still running from before, so you just need to point Chromium at the fresh build:

10. On the Pi terminal: killall chromium-browser (or just press Alt+F4 in the kiosk until it closes).
11. Click the Gillis desktop icon to relaunch.
12. Or, if a kiosk is already open: press Ctrl+R to refresh — fastest.

# Iterating during the day

After step 6 works once, every subsequent change you make in Claude on the client PC is just:

.\deploy-pi-onsite.ps1

Then refresh the kiosk with Ctrl+R. Roughly a 30–60 second loop per change.

# Troubleshooting

## Gillis.local doesn't resolve, even with the IP entered

Almost always client WiFi isolation — guest networks and enterprise WiFi often block devices from seeing each other. Two workarounds:

- Put both Pi and PC on your phone's hotspot. Re-run hostname -I on the Pi to get its new IP, then re-deploy.
- Connect Pi and PC directly with an Ethernet cable if both have ports. Wait ~30 seconds for both to assign 169.254.x.x link-local addresses; deploy script will find the Pi.

## SSH says "Permission denied (publickey)"

The deploy script's looking for gillis_deploy_key next to itself. If that didn't make it onto the USB, fall back to copying the key into Windows' default SSH location:

mkdir $env:USERPROFILE\.ssh -Force

Copy-Item .\gillis_deploy_key "$env:USERPROFILE\.ssh\id_ed25519"

Copy-Item .\gillis_deploy_key.pub "$env:USERPROFILE\.ssh\id_ed25519.pub"

## Build fails on the Pi with "Killed" or "out of memory"

Pi 4 has tight RAM. One-time fix: increase swap on the Pi via SSH:

sudo dphys-swapfile swapoff

sudo sed -i 's/^CONF_SWAPSIZE=.*/CONF_SWAPSIZE=2048/' /etc/dphys-swapfile

sudo dphys-swapfile setup

sudo dphys-swapfile swapon

Then re-run the deploy.

## Backend doesn't seem to be running

Click the Gillis desktop icon — the launcher script checks if the backend is up on 8787 and starts it if not, then opens Chromium. If the icon's missing or broken, start the backend manually:

cd /home/ionetic/Desktop/gillis-v2-ui-v2

GILLIS_SERIAL=real npm run server

Watch for "server listening on 8787". Then open another terminal and:

chromium-browser --kiosk http://localhost:8787

## Kiosk Chromium is stuck — can't get out

On a keyboard: Alt+F4 closes the window. Ctrl+Q quits Chromium entirely. If both are intercepted, switch to a TTY with Ctrl+Alt+F2, log in as ionetic, kill all chromium: killall -9 chromium-browser, then switch back with Ctrl+Alt+F7.

## Display rotation lost / touch wrong after Pi reboot

The persistent rotation lives in ~/.config/labwc/autostart. If it got wiped, recreate it via SSH:

cat > ~/.config/labwc/autostart <<'EOF'

#!/bin/sh

wlr-randr --output DSI-1 --transform 270 &

EOF

chmod +x ~/.config/labwc/autostart

Touch calibration matrix lives in /etc/udev/rules.d/99-touchscreen-rotate.rules — see PI_WIRELESS_DEPLOY_SETUP.md if you need to recreate that too.

# Before you leave the client

Optional but worth doing:

- Delete the Claude Programming folder from the client PC's Desktop (it's their PC).
- Eject the USB stick properly: right-click in File Explorer → Eject.
- Confirm any code changes you want to keep are saved back to the USB folder (so they'll sync home when you OneDrive them).
- Take a quick photo of the Pi screen / pendant in its final state — useful if anything looks off when you get home.

Gillis V2 — Onsite Deploy Runbook
