zgray8298/gillis-v2/docs/Onsite_Update_Walkthrough.docx

Gillis V2

On-Site Update Walkthrough

This document covers how to deploy updates to a Gillis V2 machine when you are at a client site, using a fresh PC (e.g. a borrowed laptop or the client’s own machine). Updates have two parts:

- Pi-side code (the operator GUI and Node backend) — shipped over SSH via deploy-pi-onsite.ps1.
- Teensy firmware — flashed via USB using Arduino IDE.

Both halves of a release that changes the serial protocol (e.g. this commit’s TRAM_PREVIEW addition) must ship together. Order matters: firmware first, then GUI.

# Prerequisites

Verify these once before the visit so you are not chasing them at the client site:

- Git for Windows installed on the PC (download from gitforwindows.org).
- An SSH key the Pi accepts. Either copy your gillis_deploy_key onto a USB stick (the on-site deploy script will pick it up if dropped next to the script), or copy your normal ~/.ssh/id_ed25519 into the PC’s C:\Users\<username>\.ssh\ folder.
- Arduino IDE 2.x with Teensyduino installed (only required if you are flashing firmware this visit — skip for GUI-only changes).
- The PC and the Pi must be on the same network — same WiFi SSID or wired into the same router.

# Step 1 — Pull the latest code

First time at this PC, clone the repo from GitHub:

cd C:\dev # or wherever you keep code

git clone https://github.com/zgray8298/gillis-v2.git

cd gillis-v2

Returning to a PC where you have cloned before, just pull:

cd C:\dev\gillis-v2

git pull

git pull fetches whatever you pushed from home and fast-forwards your local copy. Always do this before deploying — it is how the new code reaches the client site.

# Step 2 — Deploy the GUI to the Pi

From the gillis-v2 folder on the client PC:

.\deploy-pi-onsite.ps1

This is the right script for a client PC because it pushes source files to the Pi and builds on the Pi itself, so the client PC does not need Node.js installed. The script will:

1. Look for gillis_deploy_key next to itself, falling back to your ~/.ssh/id_ed25519.
2. Try to reach the Pi at Gillis.local, then 192.168.11.212, then prompt you for an IP if neither resolves.
3. SCP the source files over to /home/ionetic/Desktop/gillis-v2-ui-v2/.
4. Run npm install + npm run build on the Pi (takes about 30 to 60 seconds on a Pi 4).

When the script finishes, restart the backend so it picks up any new server/ code:

ssh ionetic@Gillis.local "pkill -f 'node server/index.js'"

Then on the Pi itself, double-click the Gillis Welder desktop icon — the launcher checks port 8787, starts a fresh backend if needed, and opens Chromium in kiosk mode. If the kiosk is already up, just press Ctrl+R to refresh the browser and pick up the new frontend.

# Step 3 — Flash the firmware (only if firmware/ changed)

Skip this step if your changes were GUI-only.

5. Connect a USB cable from the client PC to the Teensy 4.1.
6. Open Arduino IDE 2.x on the PC.
7. File → Open → C:\dev\gillis-v2\firmware\gillis_firmware\gillis_firmware.ino.
8. Tools → Board → Teensy 4.1 (requires Teensyduino).
9. Tools → Port → select the COM port that shows the Teensy (it will be labelled).
10. Click the Upload button (right arrow). Compile takes 10 to 15 seconds; upload is near-instant.

After upload the Teensy reboots. The Pi’s backend will reconnect to the serial port automatically — you should see the Teensy dot in the top bar of the GUI go green again within a few seconds.

# Order when both sides changed

When a release changes both firmware and GUI (e.g. the TRAM_PREVIEW command added 2026-05-18), order matters:

11. Firmware first — flash the Teensy. If you deploy the GUI first, the GUI will fire commands the old firmware does not recognise and will return ERROR.
12. GUI second — run deploy-pi-onsite.ps1, restart the backend, refresh the browser.

# Quick smoke test

Once both sides are deployed, verify on the real hardware:

- Top bar: no overlapping nav tabs over the status pills (HOME / NOT HOMED / X / Y / Z / Air clusters cleanly).
- Setup → X-Axis Tramming: tapping the up/down offset buttons should physically move the right ballscrew.
- Programs → Calibrate Start → Save Start Position: an “Okay to move table back to loading position?” modal should appear.

# Debugging if something is off

The most useful one-liner from the client PC:

ssh ionetic@Gillis.local "tail -20 /tmp/gillis-server.log"

The backend logs serial-port errors, rejected commands, and orchestrator faults to that file. ERROR replies from the Teensy show up here — if you see “ERROR” responses to TRAM_PREVIEW after a deploy, the firmware has not been flashed yet.

# Common gotchas

- mDNS (Gillis.local) sometimes flakes on Windows. The deploy script auto-falls back to the home IP 192.168.11.212; if neither works, run hostname -I on the Pi to find the current IP and enter it when prompted.
- PowerShell mangles multi-line commit messages with arrows or escape characters. Use a here-string piped to git commit -F, not git commit -m, for any commit message longer than one line.
- The on-site deploy pushes source/, server/, public/, index.html, vite.config.js, eslint.config.js, package.json, package-lock.json — but not pi-kiosk/. If you change start-gillis-gui.sh or the .desktop entry, scp those over manually.
