zgray8298/gillis-v2/firmware/gillis_firmware/src/config.h

#pragma once
#define FW_VERSION_STR           "gillis-teensy-fw 2.0.0-rev4.4"
#define MICROSTEPS              16
#define FULL_STEPS_PER_REV      200
#define STEPS_PER_REV           (FULL_STEPS_PER_REV * MICROSTEPS)  // 3200
#define MM_PER_REV_X            5.0f
#define MM_PER_REV_Y            5.0f
#define STEPS_PER_MM_X          ((float)STEPS_PER_REV / MM_PER_REV_X)   // 640
#define STEPS_PER_MM_Y          ((float)STEPS_PER_REV / MM_PER_REV_Y)   // 640
#define DEFAULT_AXIS_X_MAX_MM   340.0f   // Measured X travel (Rev4 onsite, May 2026)
#define DEFAULT_AXIS_Y_MAX_MM   590.0f   // Measured Y travel (Rev4 onsite, May 2026)
#define HOMING_SPEED_MM_S       40.0f
#define HOMING_BACKOFF_MM       5.0f
#define HOMING_SLOW_SPEED_MM_S  5.0f
#define HOME_DIR_X              LOW
#define HOME_DIR_Y              LOW
#define HOMING_Y_ADVANCE_MM     0.0f
#define DEFAULT_SPEED_X_MM_S    120.0f
#define DEFAULT_SPEED_Y_MM_S    120.0f
#define DEFAULT_ACCEL_X_MM_S2   500.0f
#define DEFAULT_ACCEL_Y_MM_S2   500.0f
#define DEFAULT_CELL_SPEED_X_MM_S   60.0f
#define DEFAULT_CELL_SPEED_Y_MM_S   60.0f
#define DEFAULT_CELL_ACCEL_X_MM_S2  250.0f
#define DEFAULT_CELL_ACCEL_Y_MM_S2  250.0f
#define DEFAULT_Z_TIMEOUT_MS    5000
#define Z_TIMEOUT_MIN_MS         500
#define Z_TIMEOUT_MAX_MS       25500   // uint8 tenths-of-a-second ceiling
#define DEFAULT_DWELL_MS        50
#define DEFAULT_PRE_WELD_HOLD_MS    0
#define DEFAULT_POST_WELD_HOLD_MS   0
#define DEFAULT_ACTIVE_SOLENOID 0
#define AIR_ADC_VREF            3.3f
#define AIR_ADC_MAX             4095
#define AIR_SENSOR_MAX_VOLT     5.0f
#define AIR_DIVIDER_RATIO       (20.0f / (10.0f + 20.0f))  // 0.6667
#define AIR_SENSOR_RANGE_BAR    10.0f
#define DEFAULT_AIR_THRESHOLD_BAR  4.1f  // ~60 PSI
#define AIR_POLL_INTERVAL_MS    500
#define ALM_DEBOUNCE_MS         100
#define STEP_PULSE_US           5
#define POSITION_EVENT_INTERVAL_MS   100
#define AIR_EVENT_INTERVAL_MS        500
#define SENSORS_EVENT_INTERVAL_MS    250
#define EEPROM_MAGIC_ADDR       0       // 4 bytes
#define EEPROM_MAGIC_VALUE      0xCA1AC4D5  // Rev4.4 — Settings gained preWeldHoldMs + postWeldHoldMs (was 0xCA1AC4D4)
#define EEPROM_SETTINGS_ADDR    4       // Settings struct starts here
#define SERIAL_BAUD             115200
#define SERIAL_RX_BUF_SIZE      512     // Bumped from 128 — Rev4 JSON payloads are larger
#define LINK_WATCHDOG_ENABLED   1
#define LINK_TIMEOUT_MS         2000    // Fault if no rx byte for this long during RUN
#define LINK_HEARTBEAT_PI_MS    500
