zgray8298/gillis-v2/firmware/gillis_firmware/src/stepper.h

#pragma once
// =============================================================================
// stepper.h — Software step-generation with trapezoidal acceleration profile
// =============================================================================
// Each axis has an independent StepperAxis struct.
// stepper_run_all() is called every loop() iteration — no ISR needed on
// Teensy 4.1 at these speeds (<=200mm/s, 400 steps/mm = 80,000 steps/s max).
// At 600MHz CPU that's 7500 cycles per step — comfortable in loop().
// Rev4: adds soft-limit clamping helpers (clamp_x_to_limits / clamp_y_to_limits).
// =============================================================================

#include <Arduino.h>
#include "config.h"
#include "pins.h"
#include "settings.h"

// =============================================================================
// StepperAxis struct
// =============================================================================
struct StepperAxis {
  uint8_t  pinStep;
  uint8_t  pinDir;

  float    stepsPerMm;

  long     positionSteps;
  long     targetSteps;

  float    speedMmS;
  float    accelMmS2;

  float    currentSpeedStepsS;
  float    maxSpeedStepsS;
  float    accelStepsS2;
  long     stepsToTarget;
  long     stepsAccel;
  long     stepsDone;

  uint32_t lastStepUs;
  uint32_t stepIntervalUs;

  bool     moving;
  bool     dirPositive;
  bool     homingActive;
};

extern StepperAxis axisX;
extern StepperAxis axisYLeft;
extern StepperAxis axisYRight;

// =============================================================================
// Initialise axis structs
// =============================================================================
inline void stepper_init_axis(StepperAxis &ax, uint8_t stepPin, uint8_t dirPin, float stepsPerMm) {
  ax.pinStep            = stepPin;
  ax.pinDir             = dirPin;
  ax.stepsPerMm         = stepsPerMm;
  ax.positionSteps      = 0;
  ax.targetSteps        = 0;
  ax.moving             = false;
  ax.homingActive       = false;
  ax.currentSpeedStepsS = 0;
  ax.stepIntervalUs     = 0;
  ax.lastStepUs         = 0;
  ax.stepsDone          = 0;
  ax.stepsAccel         = 0;
}

inline void stepper_init_all() {
  stepper_init_axis(axisX,      PIN_X_STEP,  PIN_X_DIR,  STEPS_PER_MM_X);
  stepper_init_axis(axisYLeft,  PIN_YL_STEP, PIN_YL_DIR, STEPS_PER_MM_Y);
  stepper_init_axis(axisYRight, PIN_YR_STEP, PIN_YR_DIR, STEPS_PER_MM_Y);

  axisX.speedMmS       = settings.speedX;
  axisX.accelMmS2      = settings.accelX;
  axisYLeft.speedMmS   = settings.speedY;
  axisYLeft.accelMmS2  = settings.accelY;
  axisYRight.speedMmS  = settings.speedY;
  axisYRight.accelMmS2 = settings.accelY;
}

// =============================================================================
// Begin a move: set target in mm (absolute)
// =============================================================================
inline void stepper_move_to_mm(StepperAxis &ax, float targetMm) {
  long targetSteps = (long)(targetMm * ax.stepsPerMm);
  long delta = targetSteps - ax.positionSteps;
  if (delta == 0) return;

  ax.targetSteps        = targetSteps;
  ax.dirPositive        = (delta > 0);
  ax.stepsToTarget      = abs(delta);
  ax.stepsDone          = 0;
  ax.currentSpeedStepsS = 100.0f;              // start speed — avoids div-by-zero
  ax.maxSpeedStepsS     = ax.speedMmS * ax.stepsPerMm;
  ax.accelStepsS2       = ax.accelMmS2 * ax.stepsPerMm;
  ax.stepsAccel         = (long)((ax.maxSpeedStepsS * ax.maxSpeedStepsS) / (2.0f * ax.accelStepsS2));
  ax.stepIntervalUs     = (uint32_t)(1000000.0f / ax.currentSpeedStepsS);
  ax.lastStepUs         = micros();
  ax.moving             = true;

  digitalWrite(ax.pinDir, ax.dirPositive ? HIGH : LOW);
  delayMicroseconds(2); // direction setup time
}

// =============================================================================
// Begin a relative jog move (mm)
// =============================================================================
inline void stepper_jog_mm(StepperAxis &ax, float deltaMm) {
  float currentMm = (float)ax.positionSteps / ax.stepsPerMm;
  stepper_move_to_mm(ax, currentMm + deltaMm);
}

// =============================================================================
// Immediate stop — hold position
// =============================================================================
inline void stepper_stop(StepperAxis &ax) {
  ax.moving             = false;
  ax.homingActive       = false;
  ax.currentSpeedStepsS = 0;
}

inline void stepper_stop_all() {
  stepper_stop(axisX);
  stepper_stop(axisYLeft);
  stepper_stop(axisYRight);
}

// =============================================================================
// Enable / disable all drivers (shared pin)
// =============================================================================
inline void drivers_enable()  { digitalWrite(PIN_ALL_ENABLE, LOW);  }
inline void drivers_disable() { digitalWrite(PIN_ALL_ENABLE, HIGH); }

// =============================================================================
// Run one axis — call every loop()
// Trapezoidal profile: accelerate → cruise → decelerate
// =============================================================================
inline void stepper_run_axis(StepperAxis &ax) {
  if (!ax.moving) return;

  uint32_t now = micros();
  uint32_t elapsed = now - ax.lastStepUs;
  if (elapsed < ax.stepIntervalUs) return;

  long remaining = ax.stepsToTarget - ax.stepsDone;
  if (remaining <= 0) {
    ax.positionSteps      = ax.targetSteps;
    ax.moving             = false;
    ax.currentSpeedStepsS = 0;
    return;
  }

  float dt = (float)elapsed / 1000000.0f;

  long stepsToStop = (long)(ax.currentSpeedStepsS * ax.currentSpeedStepsS / (2.0f * ax.accelStepsS2));

  if (remaining <= stepsToStop) {
    ax.currentSpeedStepsS -= ax.accelStepsS2 * dt;
    if (ax.currentSpeedStepsS < 100.0f) ax.currentSpeedStepsS = 100.0f;
  } else if (ax.currentSpeedStepsS < ax.maxSpeedStepsS) {
    ax.currentSpeedStepsS += ax.accelStepsS2 * dt;
    if (ax.currentSpeedStepsS > ax.maxSpeedStepsS)
      ax.currentSpeedStepsS = ax.maxSpeedStepsS;
  }

  ax.stepIntervalUs = (uint32_t)(1000000.0f / ax.currentSpeedStepsS);

  digitalWrite(ax.pinStep, HIGH);
  delayMicroseconds(STEP_PULSE_US);
  digitalWrite(ax.pinStep, LOW);

  ax.positionSteps += ax.dirPositive ? 1 : -1;
  ax.stepsDone++;
  ax.lastStepUs = now;
}

inline void stepper_run_all() {
  stepper_run_axis(axisX);
  stepper_run_axis(axisYLeft);
  stepper_run_axis(axisYRight);
}

// =============================================================================
// Utility
// =============================================================================
inline bool stepper_is_moving(StepperAxis &ax) { return ax.moving; }

inline bool any_axis_moving() {
  return axisX.moving || axisYLeft.moving || axisYRight.moving;
}

inline float stepper_position_mm(StepperAxis &ax) {
  return (float)ax.positionSteps / ax.stepsPerMm;
}

inline void stepper_set_position_mm(StepperAxis &ax, float mm) {
  ax.positionSteps = (long)(mm * ax.stepsPerMm);
  ax.targetSteps   = ax.positionSteps;
}

// =============================================================================
// Soft-limit clamping (Rev4)
// =============================================================================
// Clamp a requested absolute X/Y target to [0, settings.maxX|maxY].
// Returns true if the value was already in range, false if it had to be
// clamped — callers can use the return to log "clamped to limit" warnings.
inline bool clamp_x_to_limits(float &mm) {
  bool inRange = true;
  if (mm < 0.0f)            { mm = 0.0f;           inRange = false; }
  if (mm > settings.maxX)   { mm = settings.maxX;  inRange = false; }
  return inRange;
}

inline bool clamp_y_to_limits(float &mm) {
  bool inRange = true;
  if (mm < 0.0f)            { mm = 0.0f;           inRange = false; }
  if (mm > settings.maxY)   { mm = settings.maxY;  inRange = false; }
  return inRange;
}
