zgray8298/gillis-v2/(commit log)

2026-05-22 Onsite fixes: calibration Z-up + save confirm, abort fault when Z down, manual cell select handlers, Pi GPIO E-stop monitor
    [config.h, fault_handler.h, gillis_firmware.ino, homing.h, pins.h, run_state.h, sensors.h, serial_protocol.h]
2026-05-22 Document E-stop wiring + Pi GPIO monitor
2026-05-31 GUI: ? help button on home, Shut Down button in Settings, manual rewrite
    GUI:
    - HomeScreen: new ? button next to the settings cog opens the operator
    manual in a full-screen iframe modal. Both ? and gear cluster bumped
    to z-20 so the IONETIC scan-ring container stops eating their clicks
    on the Pi screen.
    - SettingsScreen: red Shut Down button in the bottom-right of the
    bottom nav, behind a confirmation modal + a Shutting-down overlay.
    Greyed out mid-run / mid-homing / mid-motion. BottomNav and
    ScreenShell now accept a rightSlot for per-screen bottom-nav extras.
    - useMachine.jsx: createMachineClient moved inside useEffect so the
    WebSocket client survives React.StrictMode doubl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
2026-06-02 GUI: Manual Cell Select park-on-exit + abort/shutdown fixes
    - ProgramsScreen: prompt to move the table back to the loading position
    when leaving Manual Cell Select (Exit/Back/Home); raises Z before any XY move.
    - useMachine: clear run.paused on 'aborted' so the Settings Shut Down button
    isn't left disabled after an abort.
    - server SHUTDOWN: use sudo systemctl poweroff (clean, SD-safe) via absolute
    paths, and log stdout/stderr + exit code instead of discarding them.
    - deploy-pi-onsite.ps1: fix invalid backslash-quote escaping that broke
    PowerShell parsing of the script.
2026-10-29 Z timeout setting, fault recovery (Abort Program), remove manual Fire Laser, flash Teensy via Pi
    Firmware = what is flashed on Gillis as of 2026-10-29 (Gillis XL folder build): configurable Z timeout (default 5 s), soft Z faults keep drivers enabled, homing 40 mm/s / 60 s. NOTE: this build lacks MOVE_CAL, TRAM_PREVIEW and the abort ALM grace from the previous commit - see history to restore.
2026-10-29 Restore MOVE_CAL + TRAM_PREVIEW; Production lists programs most recently run first
    Firmware: re-add MOVE_CAL (calibration/loading-position jog with Z down) and TRAM_PREVIEW (live tramming preview) from ee6d715; nothing else changed. GUI: stamp lastRunAt on run start, sort Production by it.
2026-10-29 Restore abort grace, E-stop fault prompt, Y advance 0; fix abort/disconnect leaving run stuck
    Firmware: re-add 300 ms post-RUN_ABORT ALM grace, FAULT_ESTOP emit, HOMING_Y_ADVANCE_MM 0, 340x590 travel defaults (from ee6d715). RUN_ABORT no longer emits DONE (Pi handles it). Pi: fail stranded MOVE/JOG when sending RUN_ABORT/ABORT/STOP (pause-then-abort jammed the reply queue); end the run on Teensy disconnect and close any stale firmware run on reconnect; find the Teensy via /dev/serial/by-id. flash-teensy.ps1: more robust bootloader entry.
